kitekid250/Project-Overdrive-and-TurboCharge/Documentation/TurboCharge Diagram.pptx

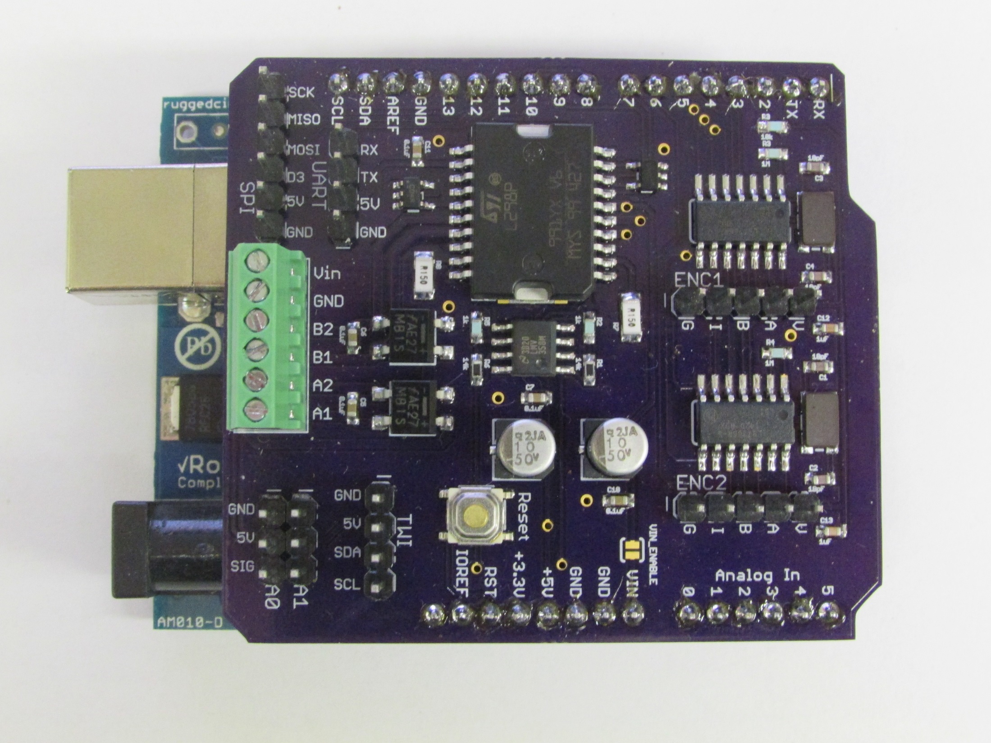
[picture p3: figure]

SPI

UART

Encoder 1

Power In and
Motors Out

Analog & PWM

I²C

Encoder 2

Reset Button

Vin Enable
