kitekid250/Project-Overdrive-and-TurboCharge/TurboCharge/Circuit/TurboCharge BOM.xlsx

PCB no | part | Vendor | part No | cost / unit | quantity/prototype | quantity to order | sub total | Desc / Location / Comments | Percent of Cost
R1,6 | 14k 0603 | Digikey | P14.0KHCT-ND (http://www.digikey.com/product-detail/en/ERJ-3EKF1402V/P14.0KHCT-ND/198160) | 0.10 | 2 | 6 | 0.60
R2,5 | 1k 0603 | Digikey | MCT0603-1.00K-CFCT-ND (http://www.digikey.com/product-detail/en/MCT06030C1001FP500/MCT0603-1.00K-CFCT-ND/2607875) | 0.08 | 2 | 6 | 0.48 |  | 0.42%
R3,4 | 1M 0603 | Digikey | MCT0603-1.00M-CFCT-ND (http://www.digikey.com/product-detail/en/MCT06030C1004FP500/MCT0603-1.00M-CFCT-ND/2607877) | 0.08 | 2 | 6 | 0.48 |  | 0.42%
R7,8 | 0.15 0603 | Digikey | 408-1584-1-ND (http://www.digikey.com/product-detail/en/KRL1632E-M-R150-F-T5/408-1584-1-ND/3737766) | 0.54 | 2 | 6 | 3.24 |  | 2.81%
R9 | 10k 0603 | Digikey | MCT0603-10.0K-CFCT-ND (http://www.digikey.com/product-detail/en/MCT06030C1002FP500/MCT0603-10.0K-CFCT-ND/2607933) | 0.08 | 1 | 3 | 0.24 |  | 0.21%
C1-4 | 18pF 0603 (50V) | Digikey | 1276-2206-1-ND (http://www.digikey.com/product-detail/en/CL10C180FB8NNNC/1276-2206-1-ND/3890292) | 0.16 | 4 | 12 | 1.92 |  | 1.67%
C5-7,10,11 | 0.1uF 0603 (25V) | Digikey | 1276-1929-1-ND (http://www.digikey.com/product-detail/en/CL10B104JA8NNNC/1276-1929-1-ND/3890015) | 0.12 | 5 | 15 | 1.80 |  | 1.56%
C8,9 | 10uF "E" (50V) | Digikey | 5652129-1-ND (http://www.digikey.com/product-search/en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) | 0.34 | 2 | 6 | 2.04 |  | 1.77%
C12,13 | 1uF 0603 (10V) | Digikey | 490-1543-1-ND (http://www.digikey.com/product-detail/en/GRM188R61A105KA61D/490-1543-1-ND/587782) | 0.10 | 2 | 6 | 0.60 |  | 0.52%
Y1,2 | 40MHz oscil | Digikey | 535-11304-1-ND (http://www.digikey.com/product-search/en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) | 0.82 | 2 | 6 | 4.92 |  | 4.27%
U3 | L298p | Digikey | 497-3624-1-ND (http://www.digikey.com/product-search/en?pv7=2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) | 5.71 | 1 | 3 | 17.13 |  | 14.88%
U4 | LMV358SOIC | Digikey | LMV358MX/NOPBCT-ND (http://www.digikey.com/product-detail/en/LMV358MX%2FNOPB/LMV358MX%2FNOPBCT-ND/1010557) | 0.87 | 1 | 3 | 2.61 |  | 2.27%
U5,6 | Single Inverter | Digikey | 296-11599-1-ND (http://www.digikey.com/product-detail/en/SN74LVC1G04DBVR/296-11599-1-ND/385738) | 0.49 | 2 | 6 | 2.94 |  | 2.55%
B1,2 | Flyback Bridge | Digikey | MB1SCT-ND (http://www.digikey.com/product-detail/en/MB1S/MB1SCT-ND/2094421) | 0.45 | 2 | 6 | 2.70 |  | 2.35%
S1 | Button | Digikey | CKN9104CT-ND (http://www.digikey.com/product-search/en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) | 0.65 | 1 | 3 | 1.95 |  | 1.69%
U1,2 | LS7366R-S | US Digital | LS7366R-S (http://www.usdigital.com/products/interfaces/ics/lfls7366r-s) | 5.60 | 2 | 6 | 33.60 |  | 29.19%
Hdr pins | 1x40 pin hdr | Digikey | A26509-25-ND (http://www.digikey.com/product-detail/en/4-103741-0-25/A26509-25-ND/683410) | 1.41 | 2 | 6 | 8.46 |  | 7.35%
Pwr Con | Terminal Blocks | Digikey | ED10565-ND (http://www.digikey.com/product-detail/en/OSTVN06A150/ED10565-ND/1588866) | 1.47 | 1 | 3 | 4.41 |  | 3.83%
- | Arduino | ? | ? | 30.00 | 0 | 0 | 0.00 |  | 0.00%
PCB | - | OSH park | - | 25.00 | 0.33 | 1 | 25.00 | Less expensive | 21.72%
PCB | - | 4pcb | - | 33.00 | 0.00 | 0 | 0.00 | More expensive | 0.00%
Prototypes | 3 |  |  |  |  |  | 115.12
 |  |  |  |  |  | Cost/prototype | 38.37
