kitekid250/Project-Overdrive-and-TurboCharge/OverDrive/Circuit/OverDrive BOM.xlsx

PCB no | part | Vendor | part No | cost / unit | quantity/prototype | quantity to order | sub total | Desc / Location / Comments
R1,2,9 | 10k 0603 | Digikey | MCT0603-10.0K-CFCT-ND (http://www.digikey.com/product-detail/en/MCT06030C1002FP500/MCT0603-10.0K-CFCT-ND/2607933) | 0.08 | 4 | 12 | 0.96 | Level shift, Counter Interrupt
Q1 | BSS138 | Digikey | BSS138KCT-ND (http://www.digikey.com/product-detail/en/BSS138K/BSS138KCT-ND/2410049) | 0.38 | 2 | 6 | 2.28 | Level shift
R3-8 | 1M 0603 | Digikey | MCT0603-1.00M-CFCT-ND (http://www.digikey.com/product-detail/en/MCT06030C1004FP500/MCT0603-1.00M-CFCT-ND/2607877) | 0.08 | 7 | 21 | 1.68 | Enc
C1-12 | 18pF 0603 | Digikey | 1276-2206-1-ND (http://www.digikey.com/product-detail/en/CL10C180FB8NNNC/1276-2206-1-ND/3890292) | 0.16 | 13 | 39 | 6.24 | Enc
Y1-6 | 40MHz oscil | Digikey | 535-11304-1-ND (http://www.digikey.com/product-search/en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) | 0.82 | 7 | 21 | 17.22 | Enc
Drv Header | 2mm polar hdr | Digikey | 609-2581-ND (http://www.digikey.com/product-detail/en/98414-G06-12LF/609-2581-ND/1090103) | 1.73 | 3 | 9 | 15.57 | Drv
Drv Con | 2mm polar con | Digikey | 609-3142-ND (http://www.digikey.com/product-detail/en/89361-712LF/609-3142-ND/1534989) | 1.41 | 3 | 9 | 12.69 | Drv
SPI Hdr | 2x3 through hdr | Digikey | S7071-ND (http://www.digikey.com/product-detail/en/PPTC032LFBN-RC/S7071-ND/810210) | 0.80 | 1 | 3 | 2.40
Hdr pins | 1x40 pin hdr | Digikey | A26509-40-ND (http://www.digikey.com/product-detail/en/4-103741-0/A26509-40-ND/297917) | 1.82 | 4 | 12 | 21.84
U1-6 | LS7366R-S | US Digital | LS7366R-S (http://www.usdigital.com/products/interfaces/ics/lfls7366r-s) | 4.75 | 6 | 18 | 85.50 | Enc
PCB | - | OSH park | - | 42.00 | 0.33 | 1 | 42.00 | Less expensive
PCB | - | 4pcb | - | 165.00 | 0.00 | 0 | 0.00 | More expensive
Motor Drivers | Dual Vnh5019 | Pololu | 2507 (http://www.pololu.com/product/2507) | 49.95 | 3 | 9 | 449.55 | Drv
uC | Arduino Due | Pololu | 2193 (http://www.pololu.com/product/2193) | 49.95 | 1 | 3 | 149.85 | -
Prototypes | 3 |  |  |  |  |  | 807.78
 |  |  |  |  |  | Cost/prototype | 269.26
 |  |  |  |  |  | Arduino | 49.95
 |  |  |  |  |  | Drivers | 149.85
 |  |  |  |  |  | Pop'd PCB | 41.68
 |  |  | Not included in this BOM | reason
 |  |  | 1.00 mm pitch 12 pos ribbon cable | have
 |  |  | micro USB cables | students can provide / have
 |  |  | Mechanical enclosure | …
