kitekid250/Project-Overdrive-and-TurboCharge/TurboCharge/TurboCharge_Library/Examples/OverkillValidation/eagle/basicUno.brd

## EAGLE design TurboCharge/TurboCharge_Library/Examples/OverkillValidation/eagle/basicUno.brd (2015-03-16)

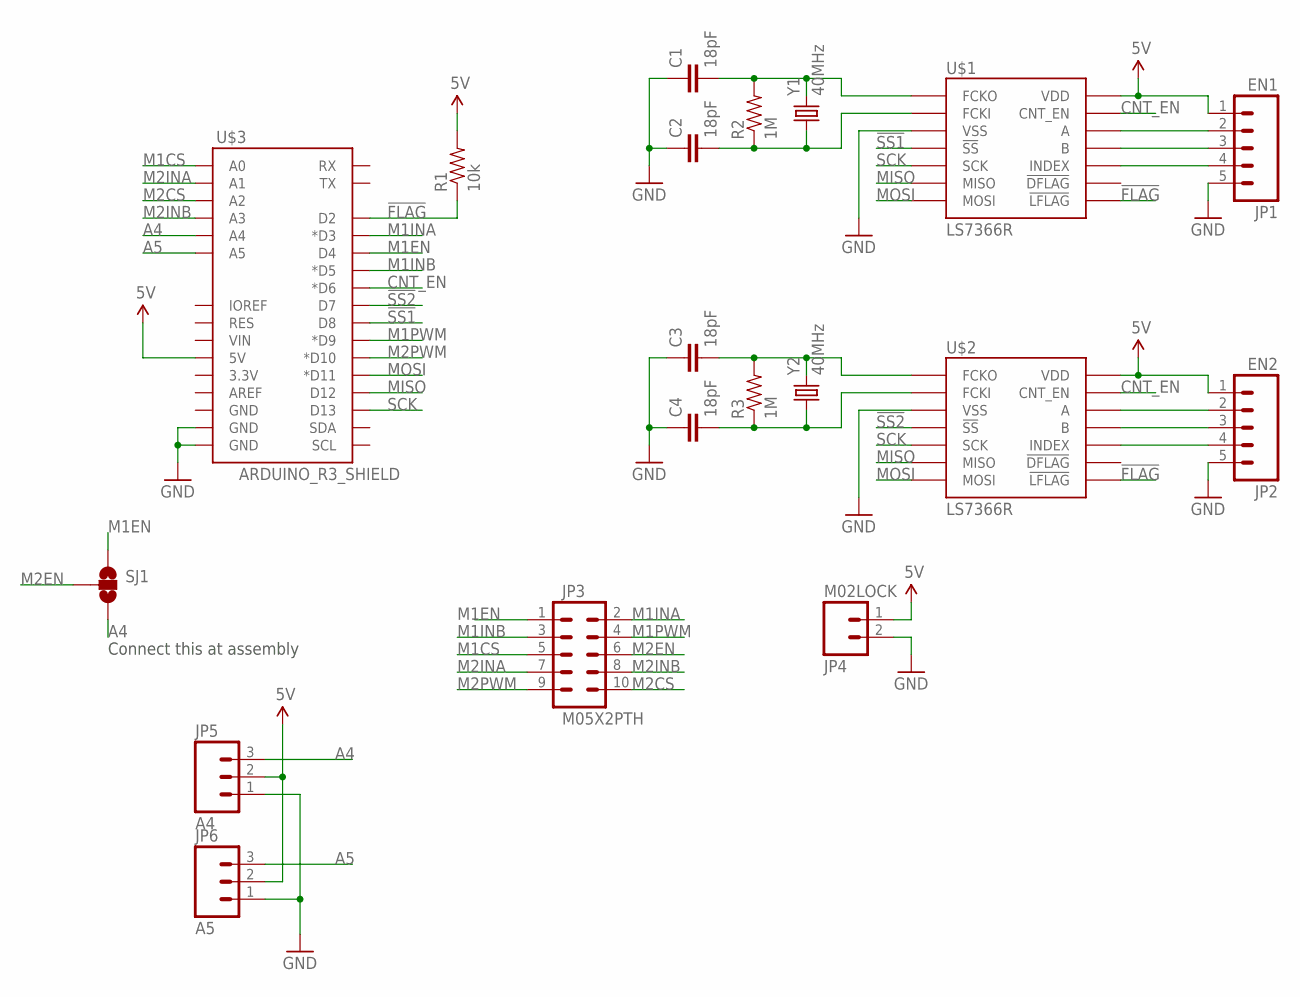
[picture p4: schematic basicUno.sch]

Parts:
C1, C2, C3, C4: 18pF; 0603-CAP
JP1: EN1; 1X05_LOCK
JP2: EN2; 1X05_LOCK
JP3: M05X2PTH; AVR_ICSP
JP4: M02LOCK; 1X02_LOCK
JP5: A4; 1X03_LOCK
JP6: A5; 1X03_LOCK
R1: 10k; AXIAL-0.4
R2, R3: 1M; 0603-RES
SJ1: SJ_2
U$1, U$2: LS7366R; SOIC14
U$3: ARDUINO_R3_SHIELD; UNO_R3_SHIELD
Y1, Y2: 40MHz; CRYSTAL-SMD-5X3

Connections:
5V: JP1.1, JP2.1, JP4.1, JP5.2, JP6.2, R1.P$2 (2), U$1.14 (VDD), U$2.14 (VDD), U$3.5V
!FLAG: R1.P$1 (1), U$1.8 (!LFLAG), U$2.8 (!LFLAG), U$3.D2
!SS1: U$1.4 (!SS), U$3.D8
!SS2: U$2.4 (!SS), U$3.D7
A4: JP5.3, SJ1.3, U$3.A4
A5: JP6.3, U$3.A5
CNT_EN: U$1.13 (CNT_EN), U$2.13 (CNT_EN), U$3.D6 (*D6)
GND: C1.1, C2.1, C3.1, C4.1, JP1.5, JP2.5, JP4.2, JP5.1, JP6.1, U$1.3 (VSS), U$2.3 (VSS), U$3.GND@0 (GND), U$3.GND@1 (GND)
M1CS: JP3.5, U$3.A0
M1EN: JP3.1, SJ1.1, U$3.D4
M1INA: JP3.2, U$3.D3 (*D3)
M1INB: JP3.3, U$3.D5 (*D5)
M1PWM: JP3.4, U$3.D9 (*D9)
M2CS: JP3.10, U$3.A2
M2EN: JP3.6, SJ1.2
M2INA: JP3.7, U$3.A1
M2INB: JP3.8, U$3.A3
M2PWM: JP3.9, U$3.D10 (*D10)
MISO: U$1.6 (MISO), U$2.6 (MISO), U$3.D12
MOSI: U$1.7 (MOSI), U$2.7 (MOSI), U$3.D11 (*D11)
unnamed: JP1.2, U$1.12 (A)
unnamed: JP1.3, U$1.11 (B)
unnamed: JP1.4, U$1.10 (INDEX)
unnamed: JP2.2, U$2.12 (A)
unnamed: JP2.3, U$2.11 (B)
unnamed: JP2.4, U$2.10 (INDEX)
unnamed: C1.2, R2.2, U$1.1 (FCKO), Y1.3 (2)
unnamed: C2.2, R2.1, U$1.2 (FCKI), Y1.1
unnamed: C3.2, R3.2, U$2.1 (FCKO), Y2.3 (2)
unnamed: C4.2, R3.1, U$2.2 (FCKI), Y2.1
SCK: U$1.5 (SCK), U$2.5 (SCK), U$3.D13

Notes on the sheet:
Connect this at assembly

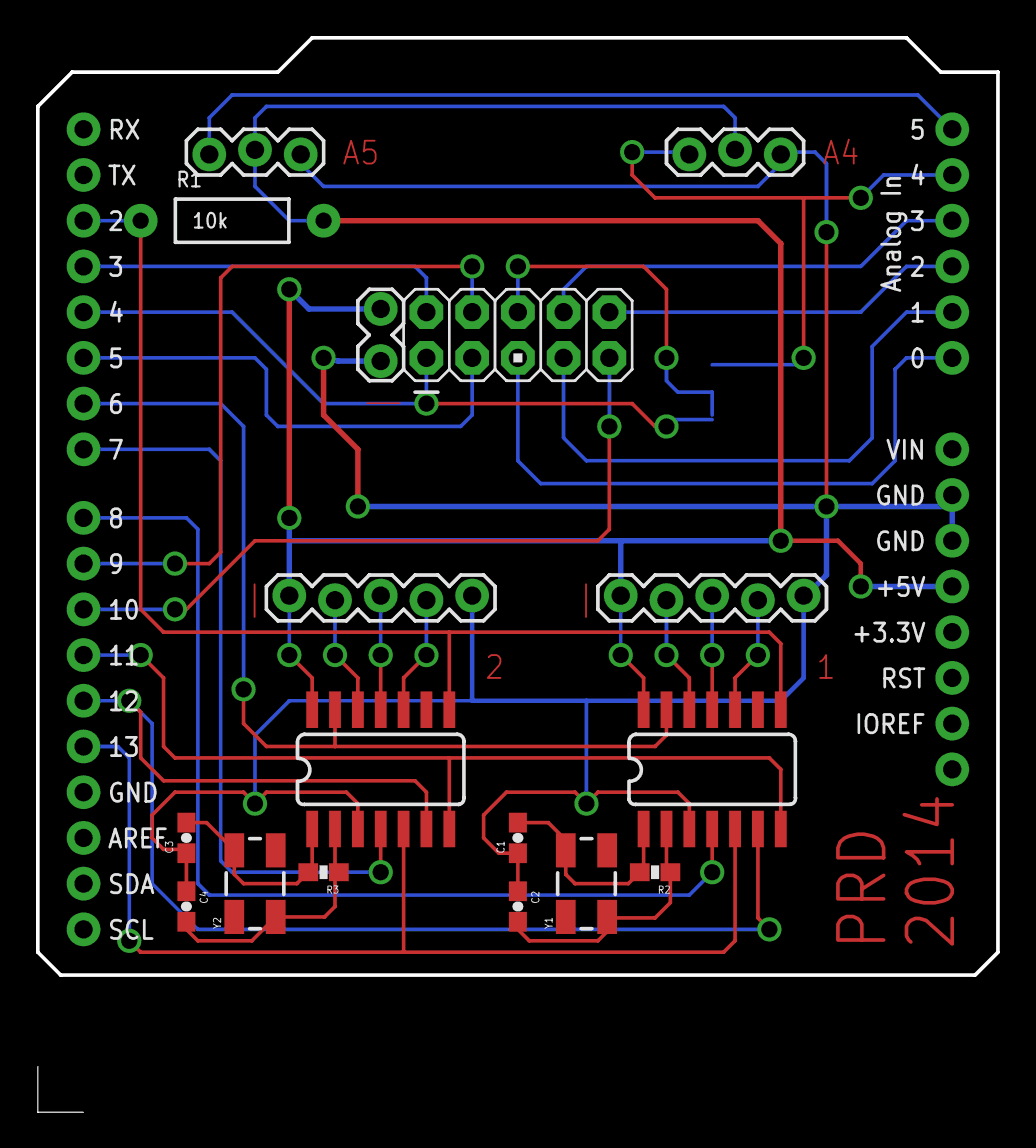
[picture p5: board basicUno.brd from above]

Board: 2 copper layers, 53.3 x 52.1 mm, 19 parts (1 on the bottom side), 31 nets.
