kitekid250/Project-Overdrive-and-TurboCharge/TurboCharge/Circuit/turbo.brd

## EAGLE design TurboCharge/Circuit/turbo.brd (2015-11-09)

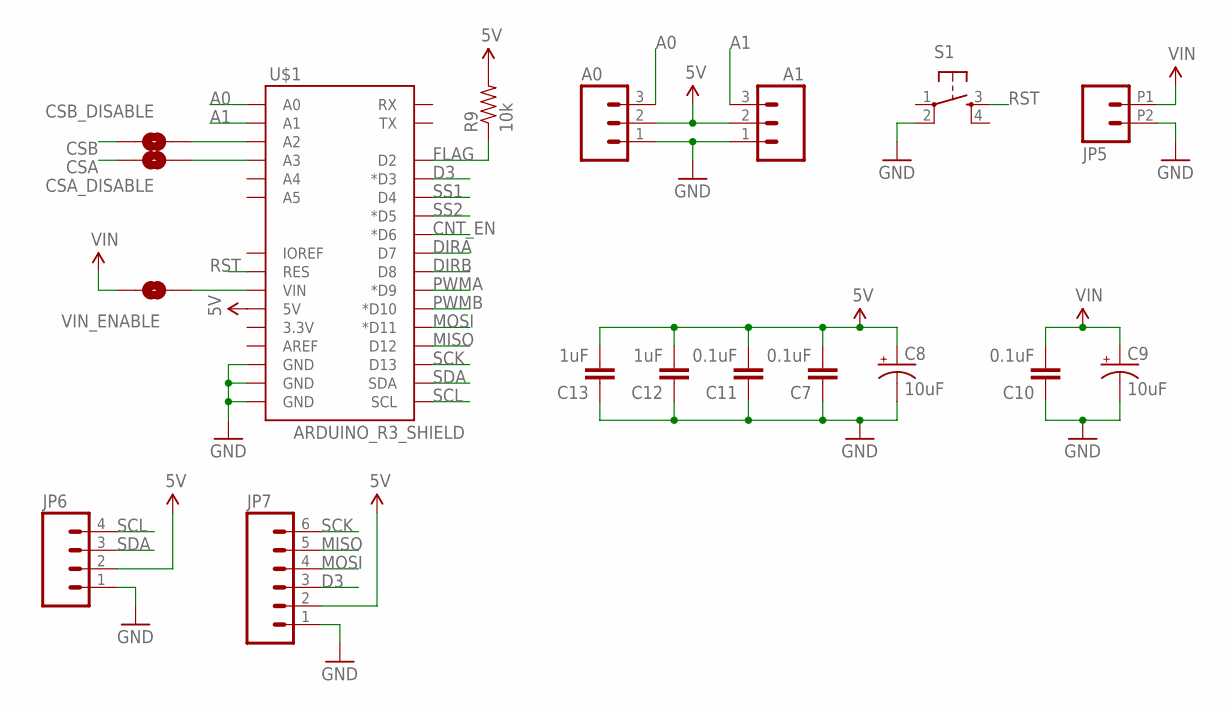
[picture p6: schematic turbo.sch, sheet 1, Shield]

Parts:
A0, A1: M03LOCK; 1X03_LOCK
C7, C10, C11: 0.1uF; 0603-CAP
C8, C9: 10uF; PANASONIC_C
C12, C13: 1uF; 0603-CAP
CSA_DISABLE: SOLDERJUMPERTRACE; SJ_2S-TRACE
CSB_DISABLE: SOLDERJUMPERTRACE; SJ_2S-TRACE
JP5: M022.54MM_SCREWTERM; 1X02_2.54_SCREWTERM
JP6: M04POLAR_LOCK; MOLEX-1X4_LOCK
JP7: M06POLAR_LOCK; MOLEX-1X6_LOCK
R9: 10k; 0603-RES
S1: TAC_SWITCHSMD; TACTILE_SWITCH_SMD
U$1: ARDUINO_R3_SHIELD; UNO_R3_SHIELD
VIN_ENABLE: SOLDERJUMPERNO; SJ_2S-NO

Connections:
5V: A0.2, A1.2, C7.2, C8.+, C11.2, C12.2, C13.2, JP6.2, JP7.2, R9.2, U$1.5V; also elsewhere on the board
A0: A0.3, U$1.A0
A1: A1.3, U$1.A1
CNT_EN: U$1.D6 (*D6); also elsewhere on the board
CSA: CSA_DISABLE.2; also elsewhere on the board
CSB: CSB_DISABLE.2; also elsewhere on the board
D3: JP7.3, U$1.D3 (*D3)
DIRA: U$1.D7; also elsewhere on the board
DIRB: U$1.D8; also elsewhere on the board
FLAG: R9.1, U$1.D2; also elsewhere on the board
GND: A0.1, A1.1, C7.1, C8.-, C9.-, C10.1, C11.1, C12.1, C13.1, JP5.P2 (2), JP6.1, JP7.1, S1.2, U$1.GND@0 (GND), U$1.GND@1 (GND), U$1.GND@2 (GND); also elsewhere on the board
MISO: JP7.5, U$1.D12; also elsewhere on the board
MOSI: JP7.4, U$1.D11 (*D11); also elsewhere on the board
unnamed: CSB_DISABLE.1, U$1.A2
unnamed: CSA_DISABLE.1, U$1.A3
unnamed: U$1.VIN, VIN_ENABLE.2
PWMA: U$1.D9 (*D9); also elsewhere on the board
PWMB: U$1.D10 (*D10); also elsewhere on the board
RST: S1.3, U$1.RES
SCK: JP7.6, U$1.D13; also elsewhere on the board
SCL: JP6.4, U$1.SCL
SDA: JP6.3, U$1.SDA
SS1: U$1.D4; also elsewhere on the board
SS2: U$1.D5 (*D5); also elsewhere on the board
VIN: C9.+, C10.2, JP5.P1 (1), VIN_ENABLE.1; also elsewhere on the board

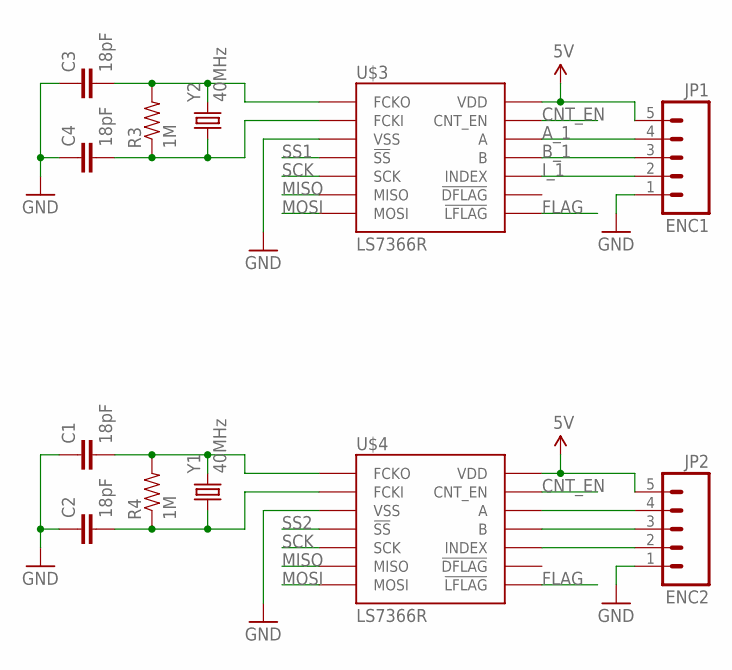
[picture p7: schematic turbo.sch, sheet 2, Encoder Counters]

Parts:
C1, C2, C3, C4: 18pF; 0603-CAP
JP1: ENC1; 1X05_LOCK
JP2: ENC2; 1X05_LOCK
R3, R4: 1M; 0603-RES
U$3, U$4: LS7366R; SOIC14
Y1, Y2: 40MHz; CRYSTAL-SMD-5X3

Connections:
5V: JP1.5, JP2.5, U$3.14 (VDD), U$4.14 (VDD); also elsewhere on the board
A_1: JP1.4, U$3.12 (A)
B_1: JP1.3, U$3.11 (B)
CNT_EN: U$3.13 (CNT_EN), U$4.13 (CNT_EN); also elsewhere on the board
FLAG: U$3.8 (!LFLAG), U$4.8 (!LFLAG); also elsewhere on the board
GND: C1.1, C2.1, C3.1, C4.1, JP1.1, JP2.1, U$3.3 (VSS), U$4.3 (VSS); also elsewhere on the board
I_1: JP1.2, U$3.10 (INDEX)
MISO: U$3.6 (MISO), U$4.6 (MISO); also elsewhere on the board
MOSI: U$3.7 (MOSI), U$4.7 (MOSI); also elsewhere on the board
unnamed: C3.2, R3.2, U$3.1 (FCKO), Y2.3 (2)
unnamed: C4.2, R3.1, U$3.2 (FCKI), Y2.1
unnamed: JP2.4, U$4.12 (A)
unnamed: JP2.3, U$4.11 (B)
unnamed: JP2.2, U$4.10 (INDEX)
unnamed: C1.2, R4.2, U$4.1 (FCKO), Y1.3 (2)
unnamed: C2.2, R4.1, U$4.2 (FCKI), Y1.1
SCK: U$3.5 (SCK), U$4.5 (SCK); also elsewhere on the board
SS1: U$3.4 (!SS); also elsewhere on the board
SS2: U$4.4 (!SS); also elsewhere on the board

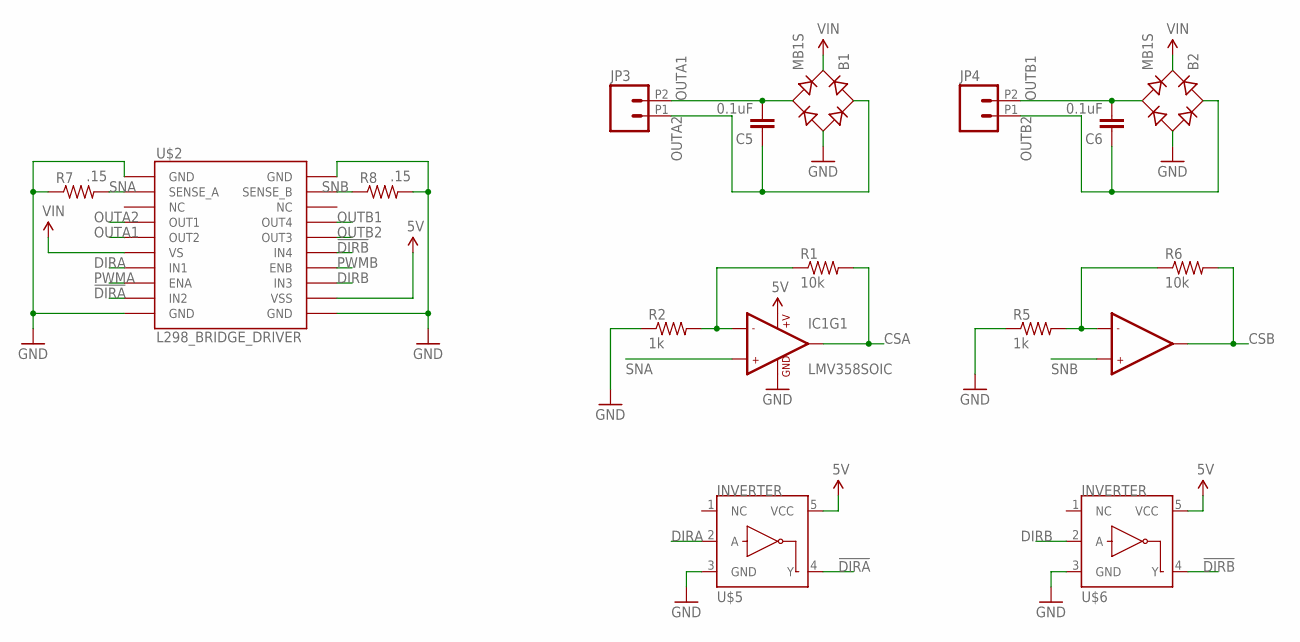
[picture p8: schematic turbo.sch, sheet 3, Motor Driver]

Parts:
B1, B2: MB1S; SOIC-4
C5, C6: 0.1uF; 0603-CAP
IC1: LMV358SOIC; SO08
JP3, JP4: M022.54MM_SCREWTERM; 1X02_2.54_SCREWTERM
R1, R6: 10k; 0603-RES
R2, R5: 1k; 0603-RES
R7, R8: .15; 1206
U$2: L298_BRIDGE_DRIVER; POWERSO20
U$5, U$6: INVERTER; SOT23-5

Connections:
5V: IC1.8 (+V), U$2.12 (VSS), U$5.5 (VCC), U$6.5 (VCC); also elsewhere on the board
!DIRA: U$2.9 (IN2), U$5.4 (Y)
!DIRB: U$2.15 (IN4), U$6.4 (Y)
CSA: IC1.1 (OUT1), R1.2; also elsewhere on the board
CSB: IC1.7 (OUT2), R6.2; also elsewhere on the board
DIRA: U$2.7 (IN1), U$5.2 (A); also elsewhere on the board
DIRB: U$2.13 (IN3), U$6.2 (A); also elsewhere on the board
GND: B1.-, B2.-, IC1.4 (GND), R2.1, R5.1, R7.1, R8.2, U$2.1 (GND), U$2.10 (GND), U$2.11 (GND), U$2.20 (GND), U$2.P$1 (GND), U$5.3 (GND), U$6.3 (GND); also elsewhere on the board
unnamed: IC1.6 (-IN2), R5.2, R6.1
unnamed: IC1.2 (-IN1), R1.1, R2.2
OUTA1: B1.~2 (AC2), C5.2, JP3.P2 (2), U$2.5 (OUT2)
OUTA2: B1.~1 (AC1), C5.1, JP3.P1 (1), U$2.4 (OUT1)
OUTB1: B2.~2 (AC2), C6.2, JP4.P2 (2), U$2.17 (OUT4)
OUTB2: B2.~1 (AC1), C6.1, JP4.P1 (1), U$2.16 (OUT3)
PWMA: U$2.8 (ENA); also elsewhere on the board
PWMB: U$2.14 (ENB); also elsewhere on the board
SNA: IC1.3 (+IN1), R7.2, U$2.2 (SENSE_A)
SNB: IC1.5 (+IN2), R8.1, U$2.19 (SENSE_B)
VIN: B1.+, B2.+, U$2.6 (VS); also elsewhere on the board

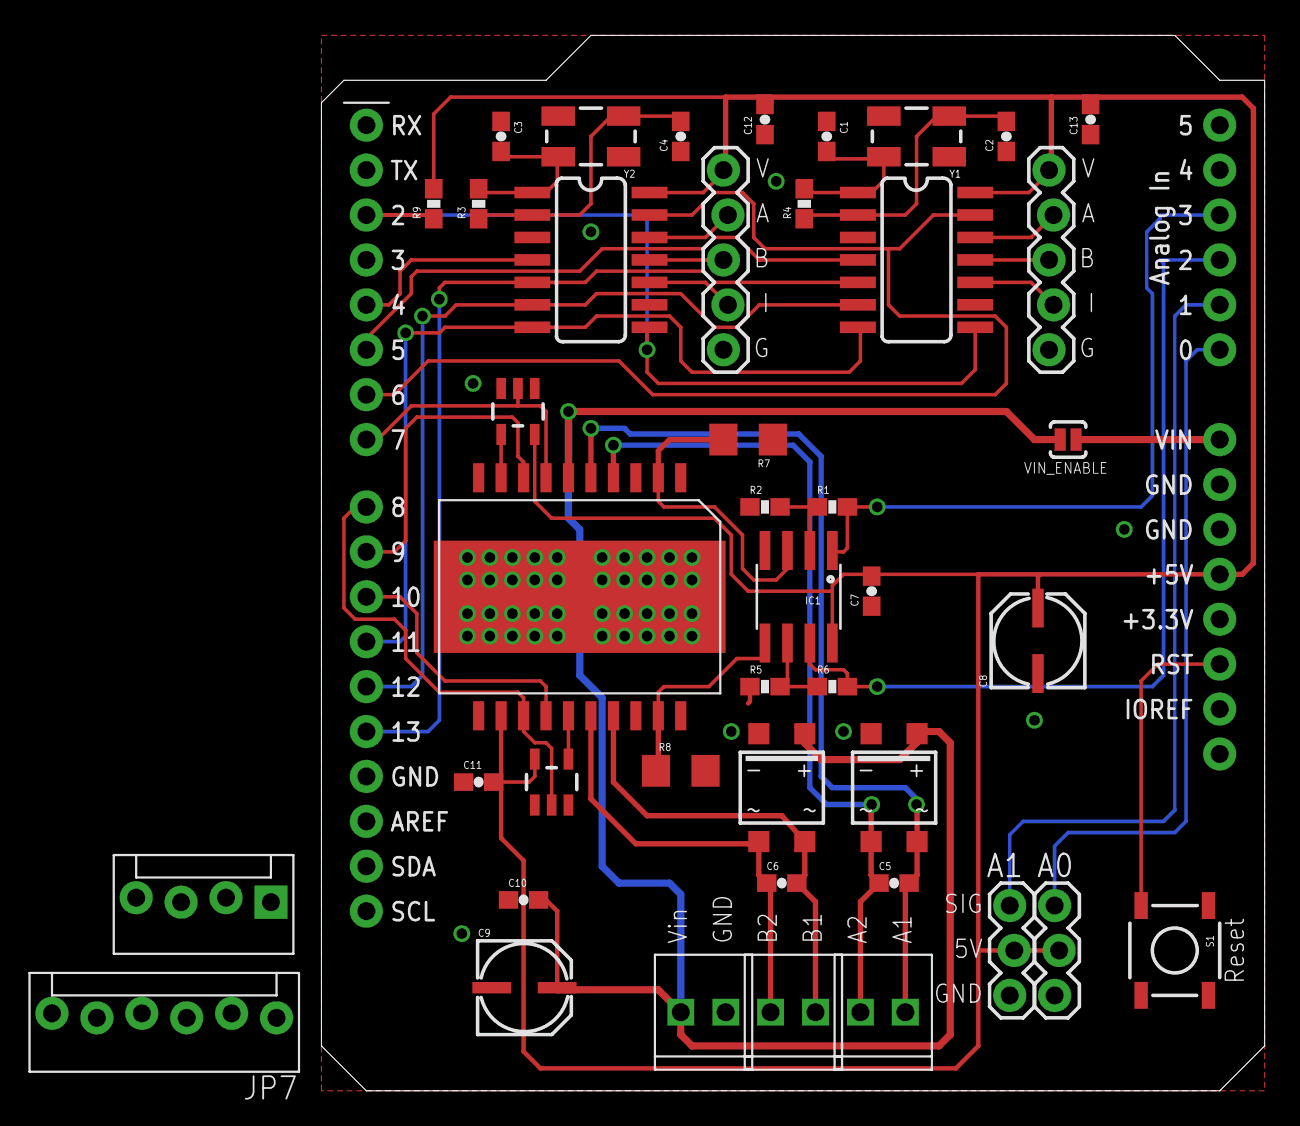
[picture p9: board turbo.brd from above]

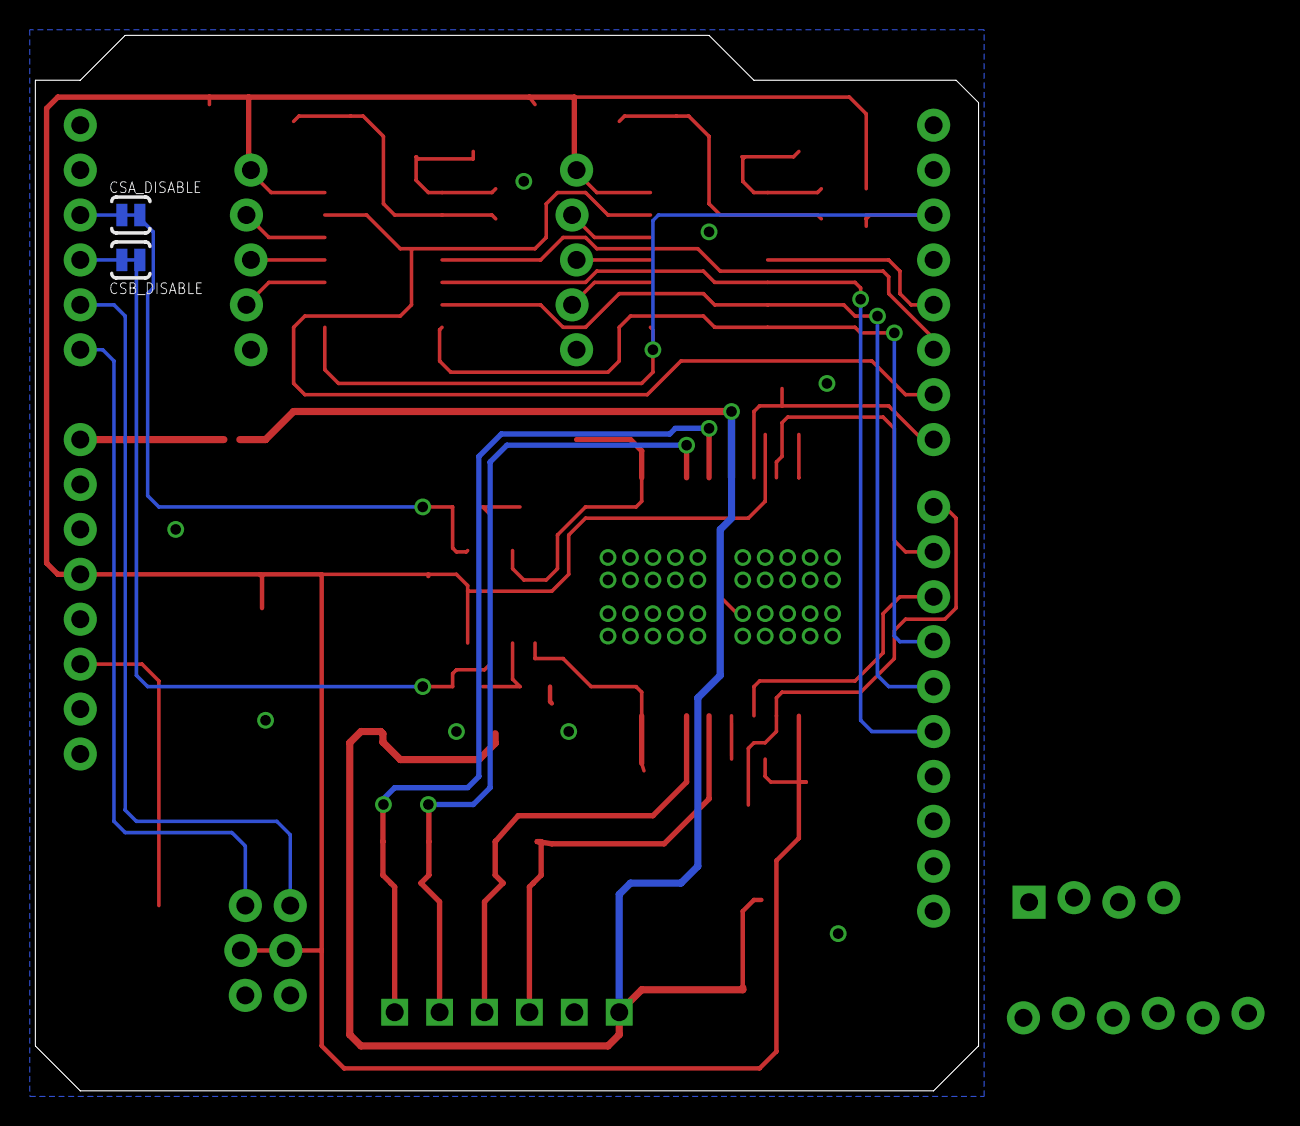
[picture p10: board turbo.brd from below]

Board: 2 copper layers, 53.3 x 59.7 mm, 46 parts (2 on the bottom side), 45 nets.
