kitekid250/Project-Overdrive-and-TurboCharge/OverDrive/Circuit/basicDueMega.brd

## EAGLE design OverDrive/Circuit/basicDueMega.brd (2015-03-16)

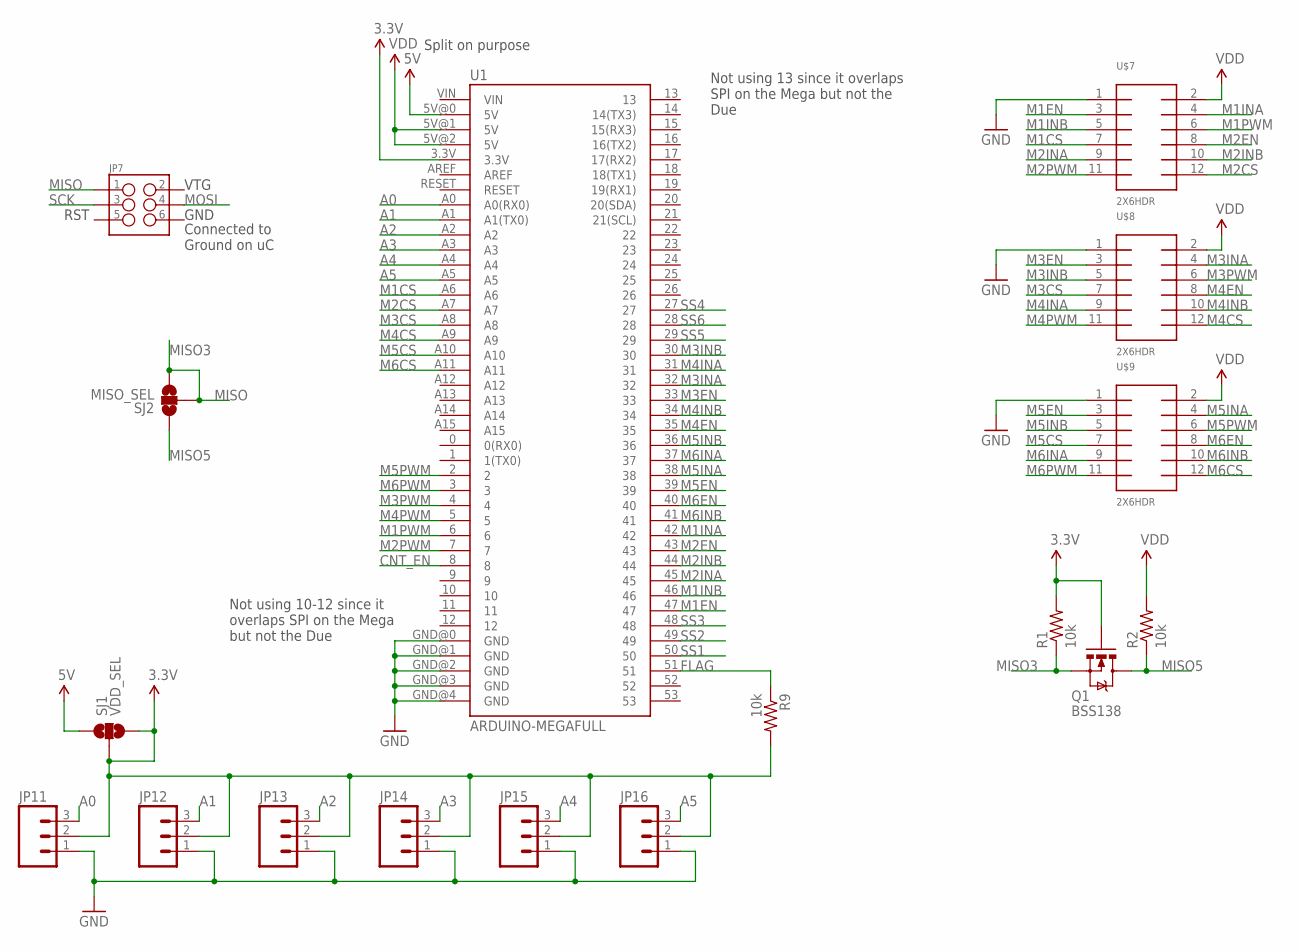
[picture p11: schematic basicDueMega.sch, sheet 1]

Parts:
JP7: M03X2POGO_PINS; 2X3_POGO
JP11, JP12, JP13, JP14, JP15, JP16: M03LOCK; 1X03_LOCK
Q1: MOSFET-NCHANNELBSS123LT1G; SOT23
R1, R2, R9: 10k; 0603-RES
SJ1: VDD_SEL; SJ_2
SJ2: MISO_SEL; SJ_2
U1: ARDUINO-MEGAFULL; ARDUINO_MEGA
U$7, U$8, U$9: 2X6HDR; 2X6_2MM_SHROUD

Connections:
3.3V: JP11.2, JP12.2, JP13.2, JP14.2, JP15.2, JP16.2, Q1.1 (G), R1.2, R9.2, SJ1.2, SJ1.3, U1.3.3V
5V: SJ1.1, U1.5V@0 (5V); also elsewhere on the board
A0: JP11.3, U1.A0 (A0(RX0))
A1: JP12.3, U1.A1 (A1(TX0))
A2: JP13.3, U1.A2
A3: JP14.3, U1.A3
A4: JP15.3, U1.A4
A5: JP16.3, U1.A5
CNT_EN: U1.8; also elsewhere on the board
FLAG: R9.1, U1.51; also elsewhere on the board
GND: JP11.1, JP12.1, JP13.1, JP14.1, JP15.1, JP16.1, U1.GND@0 (GND), U1.GND@1 (GND), U1.GND@2 (GND), U1.GND@3 (GND), U1.GND@4 (GND), U$7.1, U$8.1, U$9.1; also elsewhere on the board
M1CS: U1.A6, U$7.7
M1EN: U1.47, U$7.3
M1INA: U1.42, U$7.4
M1INB: U1.46, U$7.5
M1PWM: U1.6, U$7.6
M2CS: U1.A7, U$7.12
M2EN: U1.43, U$7.8
M2INA: U1.45, U$7.9
M2INB: U1.44, U$7.10
M2PWM: U1.7, U$7.11
M3CS: U1.A8, U$8.7
M3EN: U1.33, U$8.3
M3INA: U1.32, U$8.4
M3INB: U1.30, U$8.5
M3PWM: U1.4, U$8.6
M4CS: U1.A9, U$8.12
M4EN: U1.35, U$8.8
M4INA: U1.31, U$8.9
M4INB: U1.34, U$8.10
M4PWM: U1.5, U$8.11
M5CS: U1.A10, U$9.7
M5EN: U1.39, U$9.3
M5INA: U1.38, U$9.4
M5INB: U1.36, U$9.5
M5PWM: U1.2, U$9.6
M6CS: U1.A11, U$9.12
M6EN: U1.40, U$9.8
M6INA: U1.37, U$9.9
M6INB: U1.41, U$9.10
M6PWM: U1.3, U$9.11
MISO3: JP7.P$1 (1), Q1.2 (S), R1.1, SJ2.2, SJ2.3
MISO5: Q1.3 (D), R2.1, SJ2.1; also elsewhere on the board
MOSI: JP7.P$4 (4); also elsewhere on the board
SCK: JP7.P$3 (3); also elsewhere on the board
SS1: U1.50; also elsewhere on the board
SS2: U1.49; also elsewhere on the board
SS3: U1.48; also elsewhere on the board
SS4: U1.27; also elsewhere on the board
SS5: U1.29; also elsewhere on the board
SS6: U1.28; also elsewhere on the board
VDD: R2.2, U1.5V@1 (5V), U1.5V@2 (5V), U$7.2, U$8.2, U$9.2

Notes on the sheet:
BSS138
Connected to Ground on uC
VTG
Not using 13 since it overlaps SPI on the Mega but not the Due
Not using 10-12 since it overlaps SPI on the Mega but not the Due
MISO
RST
GND
Split on purpose

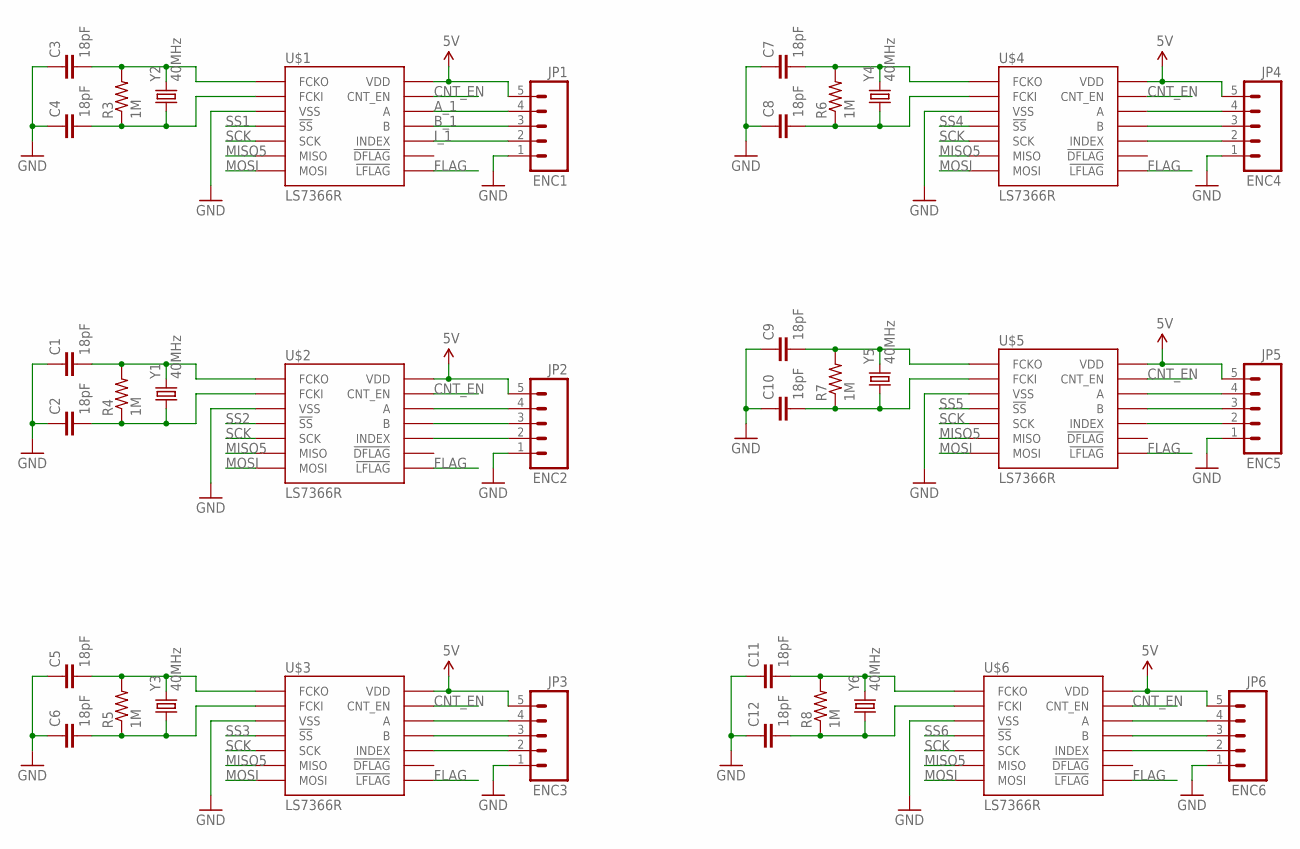
[picture p12: schematic basicDueMega.sch, sheet 2, LS7366R-S]

Parts:
C1, C2, C3, C4, C5, C6, C7, C8, C9, C10, C11, C12: 18pF; 0603-CAP
JP1: ENC1; 1X05_LOCK
JP2: ENC2; 1X05_LOCK
JP3: ENC3; 1X05_LOCK
JP4: ENC4; 1X05_LOCK
JP5: ENC5; 1X05_LOCK
JP6: ENC6; 1X05_LOCK
R3, R4, R5, R6, R7, R8: 1M; 0603-RES
U$1, U$2, U$3, U$4, U$5, U$6: LS7366R; SOIC14
Y1, Y2, Y3, Y4, Y5, Y6: 40MHz; CRYSTAL-SMD-5X3

Connections:
5V: JP1.5, JP2.5, JP3.5, JP4.5, JP5.5, JP6.5, U$1.14 (VDD), U$2.14 (VDD), U$3.14 (VDD), U$4.14 (VDD), U$5.14 (VDD), U$6.14 (VDD); also elsewhere on the board
A_1: JP1.4, U$1.12 (A)
B_1: JP1.3, U$1.11 (B)
CNT_EN: U$1.13 (CNT_EN), U$2.13 (CNT_EN), U$3.13 (CNT_EN), U$4.13 (CNT_EN), U$5.13 (CNT_EN), U$6.13 (CNT_EN); also elsewhere on the board
FLAG: U$1.8 (!LFLAG), U$2.8 (!LFLAG), U$3.8 (!LFLAG), U$4.8 (!LFLAG), U$5.8 (!LFLAG), U$6.8 (!LFLAG); also elsewhere on the board
GND: C1.1, C2.1, C3.1, C4.1, C5.1, C6.1, C7.1, C8.1, C9.1, C10.1, C11.1, C12.1, JP1.1, JP2.1, JP3.1, JP4.1, JP5.1, JP6.1, U$1.3 (VSS), U$2.3 (VSS), U$3.3 (VSS), U$4.3 (VSS), U$5.3 (VSS), U$6.3 (VSS); also elsewhere on the board
I_1: JP1.2, U$1.10 (INDEX)
MISO5: U$1.6 (MISO), U$2.6 (MISO), U$3.6 (MISO), U$4.6 (MISO), U$5.6 (MISO), U$6.6 (MISO); also elsewhere on the board
MOSI: U$1.7 (MOSI), U$2.7 (MOSI), U$3.7 (MOSI), U$4.7 (MOSI), U$5.7 (MOSI), U$6.7 (MOSI); also elsewhere on the board
unnamed: C3.2, R3.2, U$1.1 (FCKO), Y2.3 (2)
unnamed: C4.2, R3.1, U$1.2 (FCKI), Y2.1
unnamed: JP2.4, U$2.12 (A)
unnamed: JP2.3, U$2.11 (B)
unnamed: JP2.2, U$2.10 (INDEX)
unnamed: C1.2, R4.2, U$2.1 (FCKO), Y1.3 (2)
unnamed: C2.2, R4.1, U$2.2 (FCKI), Y1.1
unnamed: JP3.4, U$3.12 (A)
unnamed: JP3.3, U$3.11 (B)
unnamed: JP3.2, U$3.10 (INDEX)
unnamed: C5.2, R5.2, U$3.1 (FCKO), Y3.3 (2)
unnamed: C6.2, R5.1, U$3.2 (FCKI), Y3.1
unnamed: JP4.4, U$4.12 (A)
unnamed: JP4.3, U$4.11 (B)
unnamed: JP4.2, U$4.10 (INDEX)
unnamed: C7.2, R6.2, U$4.1 (FCKO), Y4.3 (2)
unnamed: C8.2, R6.1, U$4.2 (FCKI), Y4.1
unnamed: JP5.4, U$5.12 (A)
unnamed: JP5.3, U$5.11 (B)
unnamed: JP5.2, U$5.10 (INDEX)
unnamed: C9.2, R7.2, U$5.1 (FCKO), Y5.3 (2)
unnamed: C10.2, R7.1, U$5.2 (FCKI), Y5.1
unnamed: JP6.4, U$6.12 (A)
unnamed: JP6.3, U$6.11 (B)
unnamed: JP6.2, U$6.10 (INDEX)
unnamed: C11.2, R8.2, U$6.1 (FCKO), Y6.3 (2)
unnamed: C12.2, R8.1, U$6.2 (FCKI), Y6.1
SCK: U$1.5 (SCK), U$2.5 (SCK), U$3.5 (SCK), U$4.5 (SCK), U$5.5 (SCK), U$6.5 (SCK); also elsewhere on the board
SS1: U$1.4 (!SS); also elsewhere on the board
SS2: U$2.4 (!SS); also elsewhere on the board
SS3: U$3.4 (!SS); also elsewhere on the board
SS4: U$4.4 (!SS); also elsewhere on the board
SS5: U$5.4 (!SS); also elsewhere on the board
SS6: U$6.4 (!SS); also elsewhere on the board

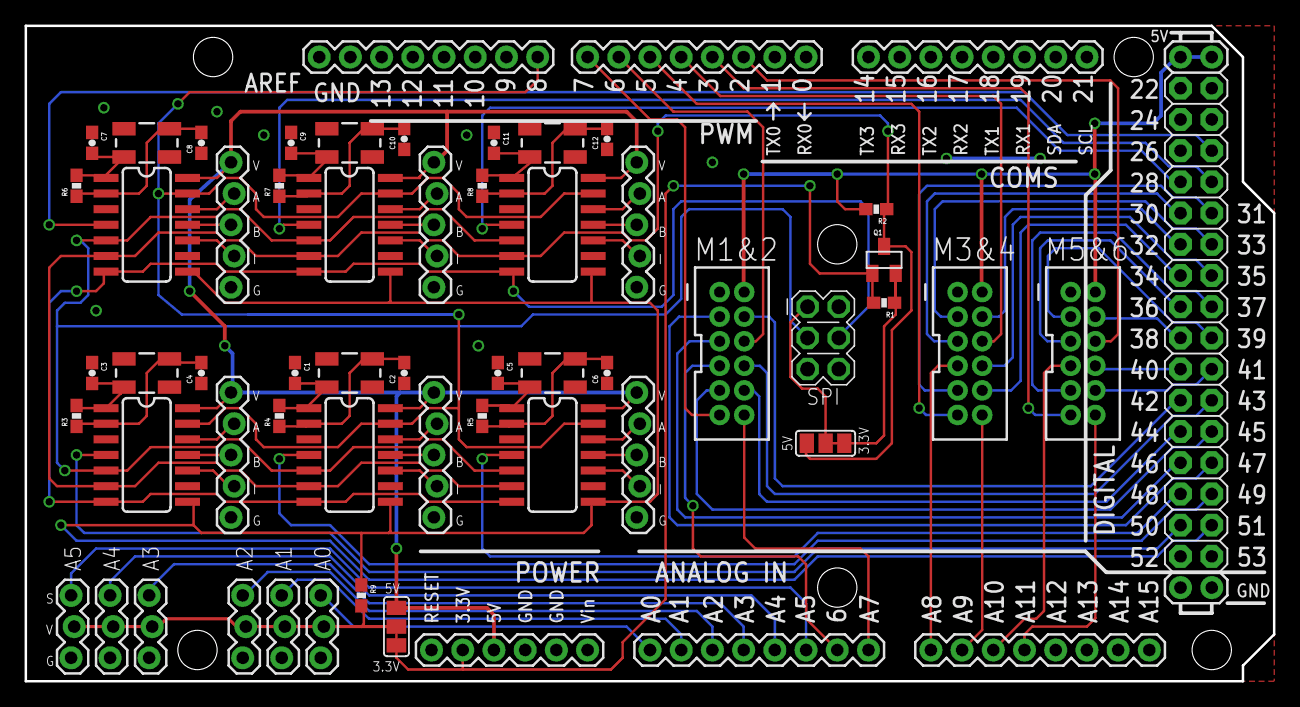
[picture p13: board basicDueMega.brd from above]

Board: 2 copper layers, 101.6 x 53.3 mm, 53 parts (0 on the bottom side), 82 nets.
