kitekid250/Project-Overdrive-and-TurboCharge/TurboCharge/TurboCharge_Library/Examples/OverkillValidation/basicUno.h

#ifndef _BASIC_UNO
#define _BASIC_UNO

// Digital Pins
#define ENC_INT 2
#define M1_INA 3
#define M1_EN 4
#define M1_INB 5
#define CNT_EN 8
#define EN2_SS 7
#define EN1_SS 50
#define M1_PWM 9
#define M2_PWM 10

// SPI library handles these
// #define MOSI 11
// #define MISO 12
// #define SCK 13

// Analog Pins
#define M1_CS 14
#define M2_INA 15
#define M2_CS 16
#define M2_INB 17

// Solder jumpers
// #define M2_EN 18
// else M2_EN -> M1_EN


#endif
