kitekid250/Project-Overdrive-and-TurboCharge/(commit log)

2015-03-16 Actual first Commit of Files being migrated
    First Commit of Files being migrated from Google Code to GitHub
    [BOM.xlsx, SPI_Testing.sdf, basicDueMega.brd, basicDueMega.sch, basicUno.brd, basicUno.sch, main.sdf]
2015-06-02 Updated Pin Definitions for Production Revision
    The pin defs in the header changed quite a bit.
2015-06-03 Fixed the issue with the SPI library and Arduino Due misbehaving in the LS7366R library. Issue was where SPI.begin() was in the constructor which caused the Due to lock up. This works in the Uno but 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
2015-06-09 Added Example and Fixed a Pin
    The example works with the due and a motor. The pin mis-mapped was
    M1_INA.
2015-10-17 Added LS User Guide PDF
    It was only in the Turbo repo though it applies to both Turbo Charge and
    OverDrive
2015-11-09 Started Merge of Two Repos, Started Markdown Documentation
    Moving towards the eventual goal of cross platform documentation, and a
    unified repo for all the libraries.
    [TurboBOM.xlsx, turbo.brd, turbo.sch, turbo_B.brd, turbo_B.sch]
2015-11-09 Updated Readme.md
    It now reflects the status of the current repo and the project as a
    whole.
2015-12-22 Big Reorg, Started Unification
    My end goal is to have single libraries for both boards that tie
    everything together. Progress was made toward this with reorg though
    the unified libraries are currently not tested as stable.
    [SPI_Testing.sdf, TurboBOM.xlsx, TurboCharge BOM.xlsx, basicDueMega.brd, basicDueMega.sch, basicUno.brd, basicUno.sch, main.sdf]
2015-12-22 Finished OverDrive Example 1, Started 2 and 3
    I have to try them on the real boards, but I like the direction they're
    heading. Quite easy to use!
2015-12-22 Remembered to update the ZIP library
    Just in case anyone wants to use this right now.
2015-12-23 OverDrive Example 2 and 3 Completed
    I didn't do much to 3, but it's more about the comments anyway.
    [CustomConfiguration.ino, E01_Overdrive_Example.ino, E02_Overdrive_PotExample.ino, E03_Encoder_CustomConfiguration.ino]
2015-12-23 Reorg Documentation
    [OverDrive BOM.xlsx, TurboBOM.xlsx, TurboCharge BOM.xlsx]
2015-12-23 Made an OverDrive User Guide, More Reorg
    Woohoo, all done for now.
    [basicUno.brd, basicUno.sch]
